PositiveAltitude/BLDC-servo-50A-v1-hardware/README.md

# 50A BLDC Servo Motor
This is an attempt to create a servomotor board for BLDC motors capable of providing 50A continuous current. 

Work in progress...
