PositiveAltitude/BLDC-servo-50A-v1-hardware/bldc_servo_50a_v1.kicad_pcb

## KiCad design bldc_servo_50a_v1.kicad_pcb (2026-09-09)

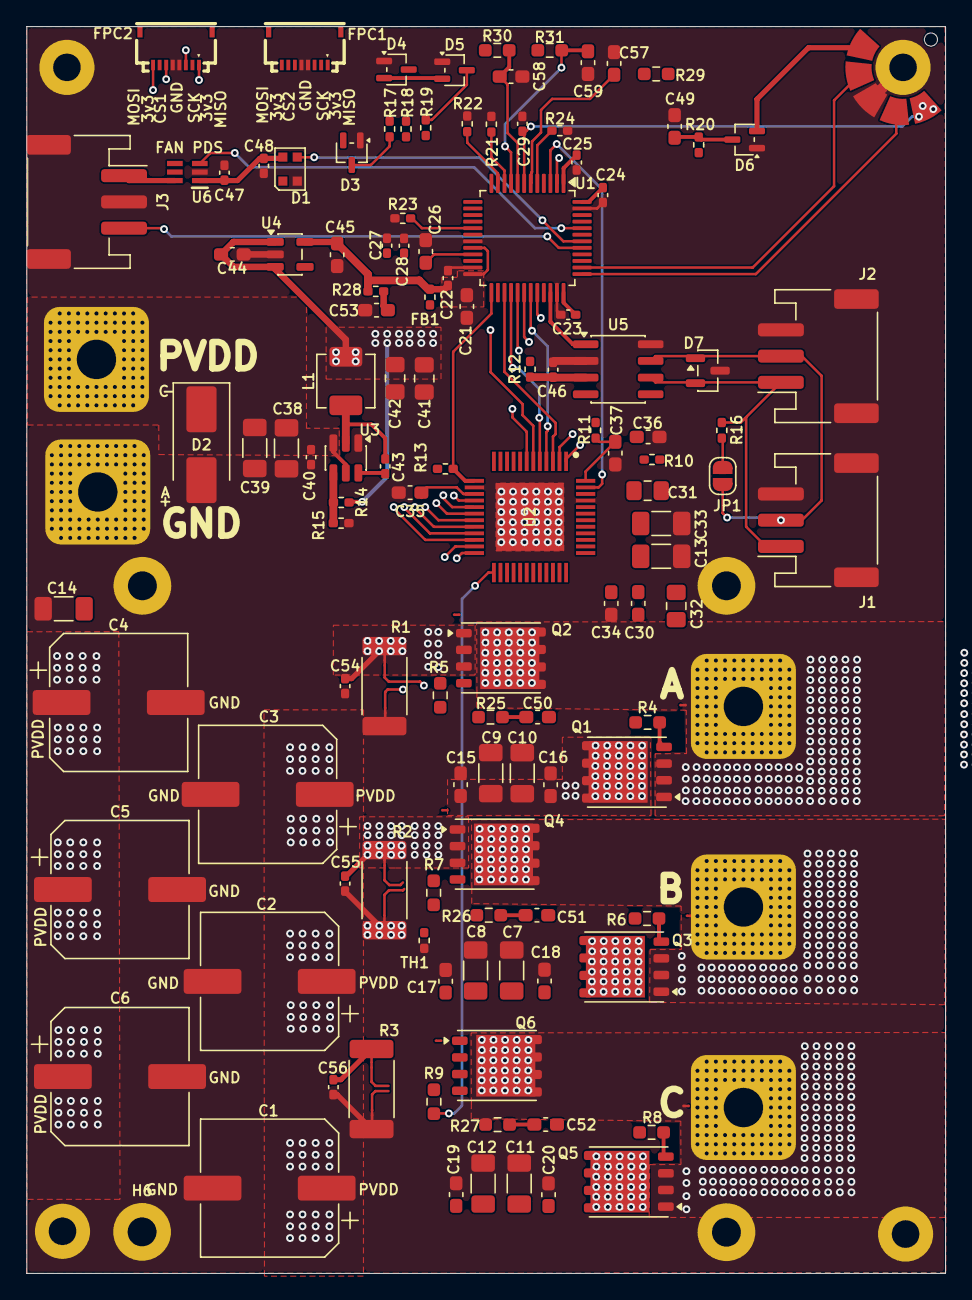
[picture p1: board bldc_servo_50a_v1.kicad_pcb from above]

Board: 4 copper layers, 70.0 x 95.0 mm, 143 parts (0 on the bottom side), 90 nets.

Parts:
C1, C2, C3, C4, C5, C6: 100u; CP_Elec_10x7.9
C7, C8, C9, C10, C11, C12, C13, C14, C33, C38, C39: 4.7u; C_1206_3216Metric_Pad1.33x1.80mm_HandSolder
C15, C16, C17, C18, C19, C20, C26, C34, C35, C36, C37, C44, C45, C49, C53, C57, C58, C59: 1u; C_0603_1608Metric_Pad1.08x0.95mm_HandSolder
C21: 4.7u; C_0603_1608Metric_Pad1.08x0.95mm_HandSolder
C22, C23, C24, C25, C27, C29, C40, C43, C46, C47, C48: 100n; C_0402_1005Metric_Pad0.74x0.62mm_HandSolder
C28: 10n; C_0402_1005Metric_Pad0.74x0.62mm_HandSolder
C30: 2.2u; C_0603_1608Metric_Pad1.08x0.95mm_HandSolder
C31, C32: 47n; C_0805_2012Metric_Pad1.18x1.45mm_HandSolder
C41, C42: 22u; C_0805_2012Metric_Pad1.18x1.45mm_HandSolder
C50, C51, C52: 1n; C_0603_1608Metric_Pad1.08x0.95mm_HandSolder
C54, C55, C56: 1n; C_0402_1005Metric_Pad0.74x0.62mm_HandSolder
D1: WS2812B-2020; LED_WS2812B-2020_PLCC4_2.0x2.0mm
D2: SMBJ28A; D_SMB_Handsoldering
D3, D4, D5, D6: BAT54SW; SOT-323_SC-70
D7: SM712_SOT23; SOT-23
FB1: BLM15AG601SN1D; R_0402_1005Metric_Pad0.72x0.64mm_HandSolder
FPC1: Encoder1; FPC-SMD_8P-P0.50_HC-FPC-05-09-8RLTAG
FPC2: Encoder2; FPC-SMD_8P-P0.50_HC-FPC-05-09-8RLTAG
H1, H2, H3: Positive_Altitude_M2_Hole
H4, H5, H6, H7: MountingHole_2.2mm_M2_Pad
J1: CAN1; JST_PH_S3B-PH-SM4-TB_1x03-1MP_P2.00mm_Horizontal
J2: CAN2; JST_PH_S3B-PH-SM4-TB_1x03-1MP_P2.00mm_Horizontal
J3: FAN; JST_PH_S3B-PH-SM4-TB_1x03-1MP_P2.00mm_Horizontal
J5: SWD; Positive_Altitude_SWD_Connector
JP1: Enable_CAN_Termination_1; SolderJumper-2_P1.3mm_Open_RoundedPad1.0x1.5mm
L1: 3.3u; L_Changjiang_FXL0420
NT1, NT2, NT3, NT4, NT5, NT6, NT7, NT8, NT9, NT10, NT11, NT12: NetTie_2; NetTie-2_SMD_Pad0.2mm
P1: PVDD; Soldering_Pad_8mm_3mm_hole
P2: GND; Soldering_Pad_8mm_3mm_hole
P3: PHASE_A; Soldering_Pad_8mm_3mm_hole
P4: PHASE_B; Soldering_Pad_8mm_3mm_hole
P5: PHASE_C; Soldering_Pad_8mm_3mm_hole
Q1, Q2, Q3, Q4, Q5, Q6: BSC010N04LS; Infineon_PG-TDSON-8_6.15x5.15mm
R1, R2, R3: 1m; R_2512_6332Metric_Pad1.40x3.35mm_HandSolder
R4, R5, R6, R7, R8, R9: 2.2; R_0603_1608Metric_Pad0.98x0.95mm_HandSolder
R10: 100; R_0402_1005Metric_Pad0.72x0.64mm_HandSolder
R11: 220; R_0402_1005Metric_Pad0.72x0.64mm_HandSolder
R12, R13, R28: 10k; R_0402_1005Metric_Pad0.72x0.64mm_HandSolder
R14: 100k; R_0402_1005Metric_Pad0.72x0.64mm_HandSolder
R15: 13.7k; R_0402_1005Metric_Pad0.72x0.64mm_HandSolder
R16: 120; R_0402_1005Metric_Pad0.72x0.64mm_HandSolder
R17, R18, R19, R20: 39k; R_0402_1005Metric_Pad0.72x0.64mm_HandSolder
R21, R22, R23, R24: 5k; R_0402_1005Metric_Pad0.72x0.64mm_HandSolder
R25, R26, R27: 10; R_0603_1608Metric_Pad0.98x0.95mm_HandSolder
R29, R30, R31: 100; R_0603_1608Metric_Pad0.98x0.95mm_HandSolder
TH1: NCP15XH103F03RC; R_0402_1005Metric_Pad0.72x0.64mm_HandSolder
U1: STM32G431CBT6; LQFP-48_7x7mm_P0.5mm
U2: DRV8305NQPHPRQ1; QFP50P900X900X120-49N
U3: LMR51430; SOT-23-6
U4: TLV75533PDBV; SOT-23-5
U5: SN65HVD230; SOIC-8_3.9x4.9mm_P1.27mm
U6: TPS22919DCKR; SOT65P210X110-6N

Connections:
+3.3V: C21.2, C22.2, C23.2, C24.2, C25.2, C45.1, C46.1, D3.2 (K), D4.2 (K), D5.2 (K), D6.2 (K), FB1.1, FPC1.2, FPC1.7, FPC2.2, FPC2.7, J5.1 (+3.3V), R11.1, R12.1, R13.1, R28.1, U1.1 (VBAT), U1.20 (VREF+), U1.24 (VDD), U1.36 (VDD), U1.48 (VDD), U4.5 (OUT), U5.3 (VCC)
+3.3VA: C26.1, C27.1, C28.1, FB1.2, U1.21 (VDDA)
+5V: C41.1, C42.1, C44.1, C47.1, C48.2, D1.4 (VDD), L1.1, R14.1, U4.1 (IN), U4.3 (EN), U6.1 (IN)
/5V_BOOT: C43.2, U3.6 (CB)
/5V_FB: R14.2, R15.1, U3.4 (FB)
/5V_SW: C43.1, L1.2, U3.2 (SW)
/CAN_H: D7.1 (A1), J1.2, J2.2, JP1.2 (B), U5.7 (CANH)
/CAN_L: D7.2 (A2), J1.1, J2.1, R16.2, U5.6 (CANL)
/CAN_RX: U1.33 (PA11), U5.4 (R)
/CAN_TX: U1.34 (PA12), U5.1 (D)
/CS_1: FPC2.6, U1.12 (PA4)
/CS_2: FPC1.6, U1.39 (PA15)
/DRV_AVDD: C35.1, U2.15 (AVDD)
/DRV_CP1H: C31.1, U2.43 (CP1H)
/DRV_CP1L: C31.2, U2.42 (CP1L)
/DRV_CP2H: C32.1, U2.39 (CP2H)
/DRV_CP2L: C32.2, U2.40 (CP2L)
/DRV_CS: U1.43 (PB6), U2.9 (NSCS)
/DRV_DVDD: C36.1, U2.46 (DVDD)
/DRV_NFAULT: R12.2, U1.22 (PB10), U2.8 (NFAULT)
/DRV_PWRGD: R13.2, U1.25 (PB11), U2.13 (PWRGD)
/DRV_VCPH: C30.1, U2.38 (VCPH)
/DRV_VCP_LSD: C34.1, U2.37 (VCP_LSD)
/DRV_VDRAIN: R10.2, U2.44 (VDRAIN)
/DRV_VREG: C37.1, R11.2, U2.48 (VREG)
/DRV_WAKE: U1.3 (PC14), U2.47 (WAKE)
/EN_GATE: U1.2 (PC13), U2.1 (EN_GATE)
/FAN_5V: J3.1, U6.6 (OUT)
/FAN_EN: U1.44 (PB7), U6.3 (ON)
/FAN_PWM: J3.3, U1.41 (PB4)
/GH_A: R4.1, U2.36 (GHA)
/GH_B: R6.1, U2.29 (GHB)
/GH_C: R8.1, U2.28 (GHC)
/GL_A: R5.1, U2.33 (GLA)
/GL_B: R7.1, U2.32 (GLB)
/GL_C: R9.1, U2.25 (GLC)
/INHA: U1.30 (PA8), U2.2 (INHA)
/INHB: U1.31 (PA9), U2.4 (INHB)
/INHC: U1.32 (PA10), U2.6 (INHC)
/INLA: U1.27 (PB13), U2.3 (INLA)
/INLB: U1.28 (PB14), U2.5 (INLB)
/INLC: U1.29 (PB15), U2.7 (INLC)
/LED: D1.3 (DIN), U1.42 (PB5)
/MISO: FPC1.1, FPC2.1, U1.14 (PA6), U2.11 (SDO)
/MOSI: FPC1.8, FPC2.8, U1.15 (PA7), U2.10 (SDI)
/NRST: C29.1, J5.5 (RESET), U1.7 (PG10)
/PHASE_A: NT3.2, P3.1 (1_1), Q1.1 (S_1), Q1.2 (S_2), Q1.3 (S_3), Q2.5 (D_1), R17.1, R25.1
/PHASE_A_SENSE: D3.3 (COM), R17.2, R21.1, U1.10 (PA2)
/PHASE_B: NT8.2, P4.1 (1_1), Q3.1 (S_1), Q3.2 (S_2), Q3.3 (S_3), Q4.5 (D_1), R18.1, R26.1
/PHASE_B_SENSE: D4.3 (COM), R18.2, R22.1, U1.11 (PA3)
/PHASE_C: NT12.2, P5.1 (1_1), Q5.1 (S_1), Q5.2 (S_2), Q5.3 (S_3), Q6.5 (D_1), R19.1, R27.1
/PHASE_C_SENSE: D5.3 (COM), R19.2, R23.1, U1.17 (PB1)
/PVDD_SENSE: C49.1, D6.3 (COM), R20.2, R24.1, U1.5 (PF0)
/R_C_PhaseA: C50.1, R25.2
/R_C_PhaseB: C51.1, R26.2
/R_C_PhaseC: C52.1, R27.2
/SCK: FPC1.3, FPC2.3, U1.13 (PA5), U2.12 (SCLK)
/SH_A: NT3.1, U2.35 (SHA)
/SH_B: NT8.1, U2.30 (SHB)
/SH_C: NT12.1, U2.27 (SHC)
/SL_A: NT1.1, U2.34 (SLA)
/SL_B: NT5.1, U2.31 (SLB)
/SL_C: NT9.1, U2.26 (SLC)
/SN1: NT4.1, U2.23 (SN1)
/SN2: NT7.1, U2.21 (SN2)
/SN3: NT11.1, U2.19 (SN3)
/SO1: R29.1, U2.16 (SO1)
/SO1_MCU: C57.1, R29.2, U1.6 (PF1)
/SO2: R30.1, U2.17 (SO2)
/SO2_MCU: C58.1, R30.2, U1.8 (PA0)
/SO3: R31.1, U2.18 (SO3)
/SO3_MCU: C59.1, R31.2, U1.9 (PA1)
/SP1: NT2.1, U2.24 (SP1)
/SP1_TOP: C54.1, NT1.2, NT2.2, Q2.1 (S_1), Q2.2 (S_2), Q2.3 (S_3), R1.1
/SP2: NT6.1, U2.22 (SP2)
/SP2_TOP: C55.1, NT5.2, NT6.2, Q4.1 (S_1), Q4.2 (S_2), Q4.3 (S_3), R2.1
/SP3: NT10.1, U2.20 (SP3)
/SP3_TOP: C56.1, NT9.2, NT10.2, Q6.1 (S_1), Q6.2 (S_2), Q6.3 (S_3), R3.1
/SWCLK: J5.2 (SWCLK), U1.38 (PA14)
/SWDIO: J5.4 (SWDIO), U1.37 (PA13)
/TEMP: C53.1, R28.2, TH1.1, U1.18 (PB2)
GND: C1.2, C2.2, C3.2, C4.2, C5.2, C6.2, C7.1, C8.1, C9.1, C10.1, C11.1, C12.1, C13.1, C14.1, C15.2, C16.2, C17.2, C18.2, C19.2, C20.2, C21.1, C22.1, C23.1, C24.1, C25.1, C26.2, C27.2, C28.2, C29.2, C33.2, C34.2, C35.2, C36.2, C37.2, C38.1, C39.2, C40.2, C41.2, C42.2, C44.2, C45.2, C46.2, C47.2, C48.1, C49.2, C53.2, C54.2, C55.2, C56.2, C57.2, C58.2, C59.2, D1.2 (VSS), D2.2 (A), D3.1 (A), D4.1 (A), D5.1 (A), D6.1 (A), D7.3 (common), FPC1.4, FPC1.5, FPC2.4, FPC2.5, H1.1 (1_1), H2.1 (1_1), H3.1 (1_1), H4.1 (1_1), H5.1 (1_1), H6.1 (1_1), H7.1 (1_1), J1.3, J1.MP (MountPin), J2.3, J2.MP (MountPin), J3.2, J3.MP (MountPin), J5.3 (GND), NT4.2, NT7.2, NT11.2, P2.1 (1_1), R1.2, R2.2, R3.2, R15.2, R21.2, R22.2, R23.2, R24.2, TH1.2, U1.19 (VSSA), U1.23 (VSS), U1.35 (VSS), U1.47 (VSS), U2.14 (GND_1), U2.45 (GND_2), U2.49 (GND_3), U3.1 (GND), U4.2 (GND), U5.2 (GND), U5.8 (Rs), U6.2 (GND)
unnamed: JP1.1 (A), R16.1
unnamed: Q1.4 (G), R4.2
unnamed: Q2.4 (G), R5.2
unnamed: Q3.4 (G), R6.2
unnamed: Q4.4 (G), R7.2
unnamed: Q5.4 (G), R8.2
unnamed: Q6.4 (G), R9.2
PVDD: C1.1, C2.1, C3.1, C4.1, C5.1, C6.1, C7.2, C8.2, C9.2, C10.2, C11.2, C12.2, C13.2, C14.2, C15.1, C16.1, C17.1, C18.1, C19.1, C20.1, C30.2, C33.1, C38.2, C39.1, C40.1, C50.2, C51.2, C52.2, D2.1 (K), P1.1 (1_1), Q1.5 (D_1), Q3.5 (D_1), Q5.5 (D_1), R10.1, R20.1, U2.41 (PVDD), U3.3 (VIN), U3.5 (EN)
