PositiveAltitude/BLDC-servo-50A-v1-hardware/bldc_servo_50a_v1.ioc

Mcu.UserName=STM32G431CBTx
PA0.Signal=ADC2_IN1
PA1.Signal=ADC2_IN2
PA10.Signal=S_TIM1_CH3
PA11.Signal=FDCAN1_RX
PA12.Signal=FDCAN1_TX
PA13.Signal=SYS_JTMS-SWDIO
PA14.Signal=SYS_JTCK-SWCLK
PA15.GPIO_Label=SPI1_NSS_ALTERNTIVE
PA15.Signal=GPIO_Input
PA2.Signal=ADC1_IN3
PA3.Signal=ADC1_IN4
PA4.Signal=SPI1_NSS
PA5.Signal=SPI1_SCK
PA6.Signal=SPI1_MISO
PA7.Signal=SPI1_MOSI
PA8.Signal=S_TIM1_CH1
PA9.Signal=S_TIM1_CH2
PB1.Signal=ADC1_IN12
PB13.Signal=TIM1_CH1N
PB14.Signal=TIM1_CH2N
PB15.Signal=TIM1_CH3N
PB2.Signal=ADC2_IN12
PB3.GPIO_Label=SPI3_SCK(UNUSED)
PB3.Signal=SPI3_SCK
PB4.GPIO_Label=TIM16_CH1(FAN)
PB4.Signal=S_TIM16_CH1
PB5.GPIO_Label=SPI3_MOSI(LED)
PB5.Signal=SPI3_MOSI
PB8-BOOT0.GPIO_Label=BOOT0
PB8-BOOT0.Signal=GPIO_Input
PF0-OSC_IN.Signal=ADC1_IN10
PF1-OSC_OUT.Signal=ADC2_IN10
