PositiveAltitude/BLDC-servo-50A-v1-hardware/(commit log)

2025-08-10 Add LICENSE
    [bldc_servo_50a_v1.kicad_sch]
2025-08-12 created fresh schematic, only added MCU and Mosfets. Pushing to save progress
    [bldc_servo_50a_v1.kicad_sch]
2025-08-12 driver and mosfets connections
    [bldc_servo_50a_v1.kicad_sch]
2025-08-13 MCU and essentials added
    [bldc_servo_50a_v1.kicad_sch]
2025-09-05 Added CAN, LDO, JST to Encoder. yet to add LEDs, and currenting limitng switch for Fan.
    [bldc_servo_50a_v1.kicad_pcb, bldc_servo_50a_v1.kicad_sch]
2025-09-25 Changes after fixes-1 done
    [bldc_servo_50a_v1.kicad_sch]
2025-10-09 STM CubeIDE-necessary pin assignments in schematic included
    [bldc_servo_50a_v1.kicad_sch]
2025-10-15 Added FAN JST
    [bldc_servo_50a_v1.kicad_sch]
2025-11-07 Completed full schematic. No ERC errors. Need to be reviewed once.
    [bldc_servo_50a_v1.kicad_sch]
2025-11-07 Some corrections with FAN Switch
    [bldc_servo_50a_v1.kicad_sch]
2025-11-10 Added some footprints
    [bldc_servo_50a_v1.kicad_sch]
2025-11-13 added more footprints
    [bldc_servo_50a_v1.kicad_sch]
2025-11-13 added more footprints, 5v buck.
    [bldc_servo_50a_v1.kicad_sch]
2025-12-02 Added some nore footprints
    [bldc_servo_50a_v1.kicad_sch]
2026-01-04 Changed 5V buck, LDO, shunts
    [bldc_servo_50a_v1.kicad_sch]
2026-01-11 FETs placed
    [bldc_servo_50a_v1.kicad_pcb, bldc_servo_50a_v1.kicad_sch]
2026-01-12 Basic tentative component placement for MCU and DRV
    [bldc_servo_50a_v1.kicad_pcb, bldc_servo_50a_v1.kicad_sch]
2026-01-17 Removed duplicate V_Sensing
    [bldc_servo_50a_v1.kicad_pcb, bldc_servo_50a_v1.kicad_sch]
2026-01-17 Structure for PCB, tentative
    [bldc_servo_50a_v1.kicad_pcb, bldc_servo_50a_v1.kicad_sch]
2026-02-06 Update TODO, schematic improvements.
    [bldc_servo_50a_v1.kicad_sch]
2026-02-08 Assign all footprints
    [bldc_servo_50a_v1.kicad_sch]
2026-02-18 Wip: before fixing footprints
    [bldc_servo_50a_v1.kicad_pcb, bldc_servo_50a_v1.kicad_sch]
2026-02-19 Schematic done
    [bldc_servo_50a_v1.kicad_pcb, bldc_servo_50a_v1.kicad_sch]
2026-02-21 Some small changes
    [bldc_servo_50a_v1.kicad_pcb, bldc_servo_50a_v1.kicad_sch]
2026-02-21 Tentative placement of FETs in PCB
    [bldc_servo_50a_v1.kicad_pcb, bldc_servo_50a_v1.kicad_sch]
2026-02-22 Placing DRV, Bulk caps, FETs
    [bldc_servo_50a_v1.kicad_pcb, bldc_servo_50a_v1.kicad_sch]
2026-02-23 Some more component placement
    [bldc_servo_50a_v1.kicad_pcb]
2026-03-17 Some routing done
    [bldc_servo_50a_v1.kicad_pcb]
2026-03-17 Placement of caps
    [bldc_servo_50a_v1.kicad_pcb]
2026-05-21 Placement changed
    [bldc_servo_50a_v1.kicad_pcb, bldc_servo_50a_v1.kicad_sch]
2026-05-25 Changed Phases placement
    [bldc_servo_50a_v1.kicad_pcb, bldc_servo_50a_v1.kicad_sch]
2026-05-27 Added TVS for CAN
    [bldc_servo_50a_v1.kicad_pcb, bldc_servo_50a_v1.kicad_sch]
2026-05-27 Tentative Component placement
    [bldc_servo_50a_v1.kicad_pcb, bldc_servo_50a_v1.kicad_sch]
2026-05-30 Placement Iteration 2
    [bldc_servo_50a_v1.kicad_pcb, bldc_servo_50a_v1.kicad_sch]
2026-06-23 Some routing
    [bldc_servo_50a_v1.kicad_pcb, bldc_servo_50a_v1.kicad_sch]
2026-06-24 Some routing, added RC filters for SOx
    [bldc_servo_50a_v1.kicad_pcb, bldc_servo_50a_v1.kicad_sch]
