PositiveAltitude/BLDC-servo-50A-v1-hardware/(notices)

Notices in the files:
bldc_servo_50a_v1.kicad_sch:
Licensed under CERN-OHL-S v2.0
See LICENSE file for details.
https://cern-ohl.web.cern.ch
